Umarb2003/Linear-Voltage-Controlled-Frequency-Generator/(list of files, drawings)

Other design files:
ELE504_Major Project_milestone 1 circuit.ms14
ELE504_Major Project_milestone 2 circuit a).ms14
ELE504_Major Project_milestone 2 circuit b).ms14
ELE504_Major Project_milestone 3 circuit.ms14
ELE504_Major Project_milestone 4 circuit.ms14
